Lochiel/WOW_Yellowteeth/Pictures/Teeth - White.jpg

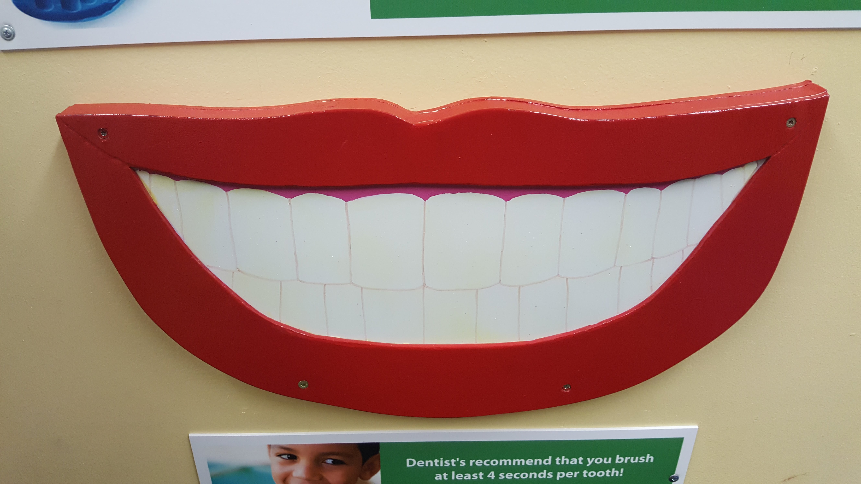
Pictures/Teeth - White.jpg
