Lochiel/WOW_Yellowteeth/Pictures/Notes, pg2.jpg

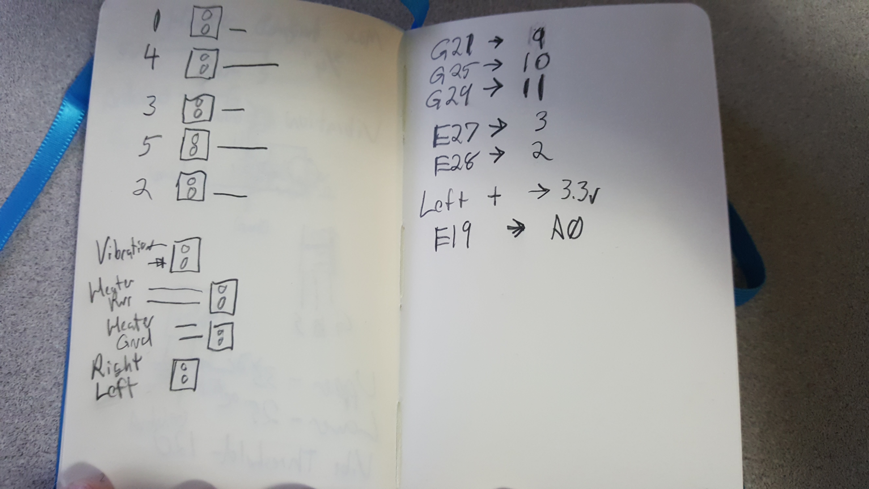
Pictures/Notes, pg2.jpg
