Lochiel/WOW_Yellowteeth/Pictures/Power control Circuit.jpg

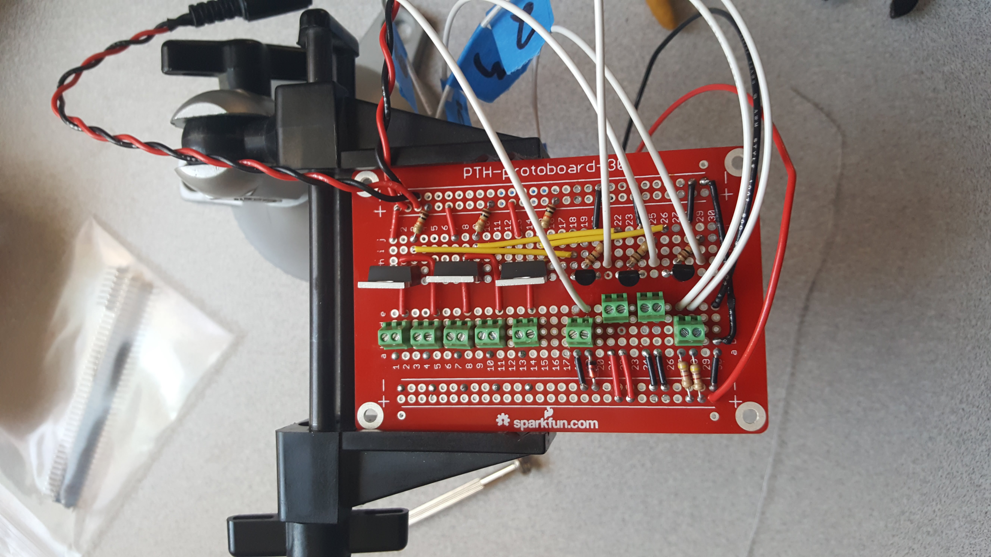
Pictures/Power control Circuit.jpg
