Lochiel/WOW_Yellowteeth/Pictures/Teeth - Yellow.jpg

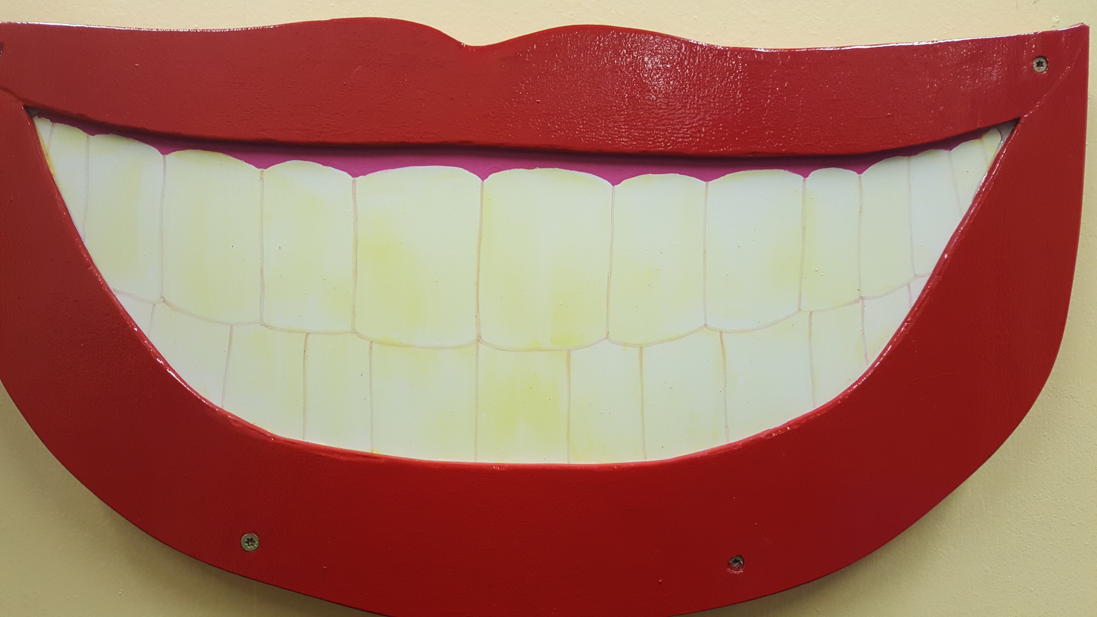
Pictures/Teeth - Yellow.jpg
