Lochiel/WOW_Yellowteeth/Pictures/Control Circuit and Arduino.jpg

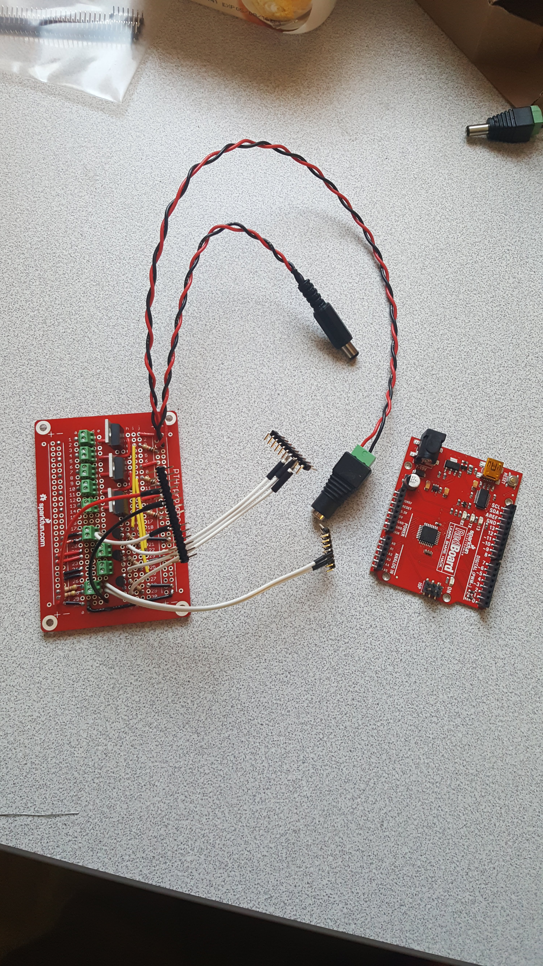
Pictures/Control Circuit and Arduino.jpg
