Lochiel/WOW_Yellowteeth/Pictures/Notes, pg1.jpg

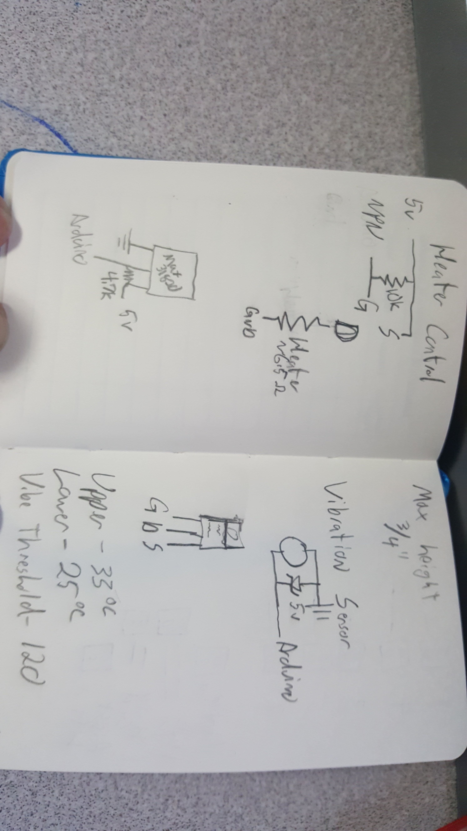
Pictures/Notes, pg1.jpg
