Lochiel/WOW_Yellowteeth/Pictures/Installation.jpg

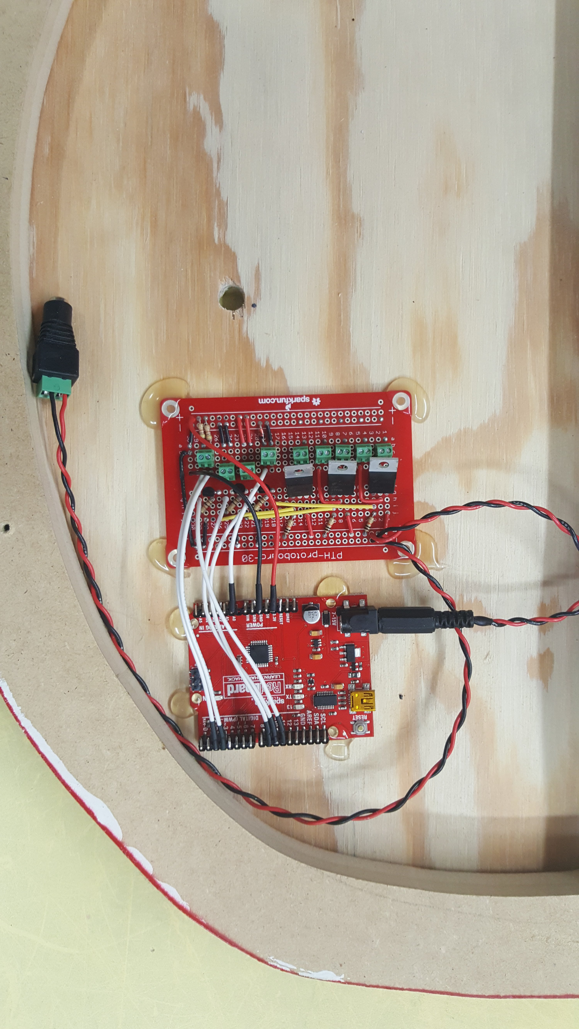
Pictures/Installation.jpg
